devinacker/upd7811-reader/adapter-qfp64/adapter-qfp64.kicad_pcb

## KiCad design adapter-qfp64/adapter-qfp64.kicad_pcb (2026-11-07)

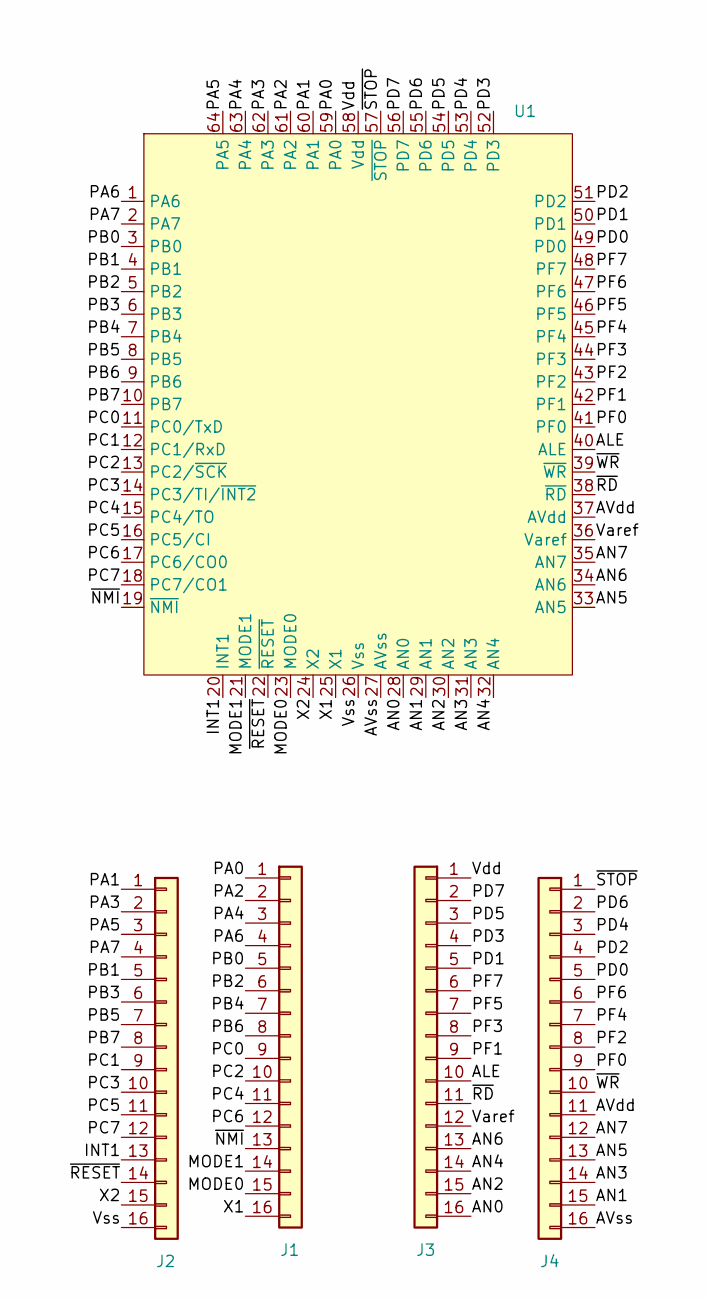
[picture p2: schematic adapter-qfp64.kicad_sch]

Parts:
J1, J2, J3, J4: Conn_01x16; PinHeader_1x16_P2.54mm_Vertical
U1: Package_QFP64

Connections:
/ALE: J3.10, U1.40 (ALE)
/AN0: J3.16, U1.28 (AN0)
/AN1: J4.15, U1.29 (AN1)
/AN2: J3.15, U1.30 (AN2)
/AN3: J4.14, U1.31 (AN3)
/AN4: J3.14, U1.32 (AN4)
/AN5: J4.13, U1.33 (AN5)
/AN6: J3.13, U1.34 (AN6)
/AN7: J4.12, U1.35 (AN7)
/AVdd: J4.11, U1.37 (AVdd)
/AVss: J4.16, U1.27 (AVss)
/INT1: J2.13, U1.20 (INT1)
/MODE0: J1.15, U1.23 (MODE0)
/MODE1: J1.14, U1.21 (MODE1)
/PA0: J1.1, U1.59 (PA0)
/PA1: J2.1, U1.60 (PA1)
/PA2: J1.2, U1.61 (PA2)
/PA3: J2.2, U1.62 (PA3)
/PA4: J1.3, U1.63 (PA4)
/PA5: J2.3, U1.64 (PA5)
/PA6: J1.4, U1.1 (PA6)
/PA7: J2.4, U1.2 (PA7)
/PB0: J1.5, U1.3 (PB0)
/PB1: J2.5, U1.4 (PB1)
/PB2: J1.6, U1.5 (PB2)
/PB3: J2.6, U1.6 (PB3)
/PB4: J1.7, U1.7 (PB4)
/PB5: J2.7, U1.8 (PB5)
/PB6: J1.8, U1.9 (PB6)
/PB7: J2.8, U1.10 (PB7)
/PC0: J1.9, U1.11 (PC0/TxD)
/PC1: J2.9, U1.12 (PC1/RxD)
/PC2: J1.10, U1.13 (PC2/~SCK)
/PC3: J2.10, U1.14 (PC3/TI/~INT2)
/PC4: J1.11, U1.15 (PC4/TO)
/PC5: J2.11, U1.16 (PC5/CI)
/PC6: J1.12, U1.17 (PC6/CO0)
/PC7: J2.12, U1.18 (PC7/CO1)
/PD0: J4.5, U1.49 (PD0)
/PD1: J3.5, U1.50 (PD1)
/PD2: J4.4, U1.51 (PD2)
/PD3: J3.4, U1.52 (PD3)
/PD4: J4.3, U1.53 (PD4)
/PD5: J3.3, U1.54 (PD5)
/PD6: J4.2, U1.55 (PD6)
/PD7: J3.2, U1.56 (PD7)
/PF0: J4.9, U1.41 (PF0)
/PF1: J3.9, U1.42 (PF1)
/PF2: J4.8, U1.43 (PF2)
/PF3: J3.8, U1.44 (PF3)
/PF4: J4.7, U1.45 (PF4)
/PF5: J3.7, U1.46 (PF5)
/PF6: J4.6, U1.47 (PF6)
/PF7: J3.6, U1.48 (PF7)
/Varef: J3.12, U1.36 (Varef)
/Vdd: J3.1, U1.58 (Vdd)
/Vss: J2.16, U1.26 (Vss)
/X1: J1.16, U1.25 (X1)
/X2: J2.15, U1.24 (X2)
/~NMI: J1.13, U1.19 (~NMI)
/~RD: J3.11, U1.38 (~RD)
/~RESET: J2.14, U1.22 (~RESET)
/~STOP: J4.1, U1.57 (~STOP)
/~WR: J4.10, U1.39 (~WR)

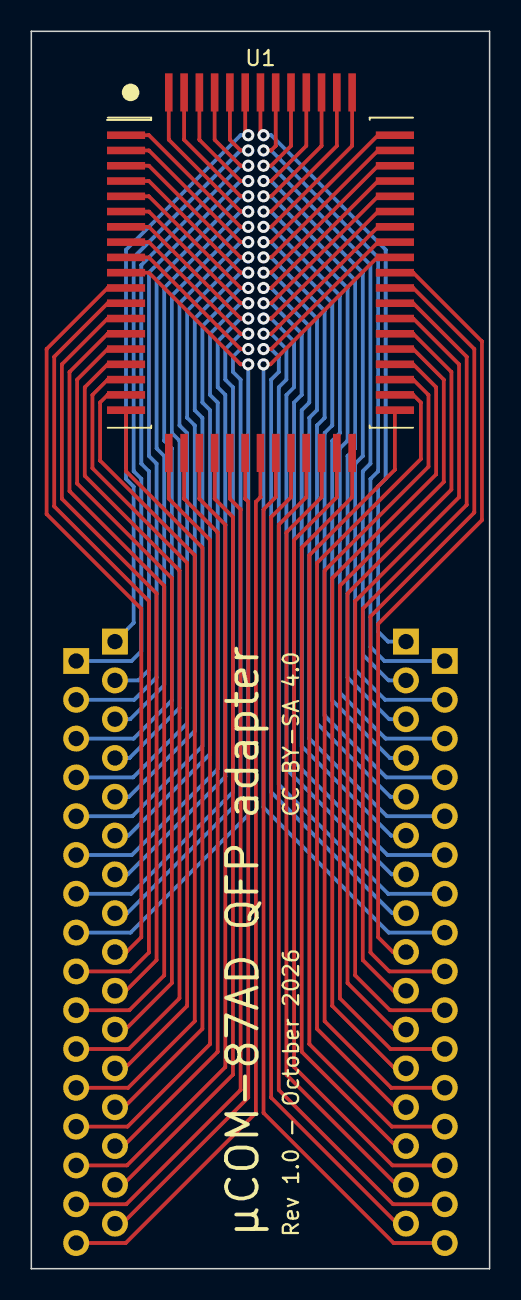
[picture p3: board adapter-qfp64.kicad_pcb from above]

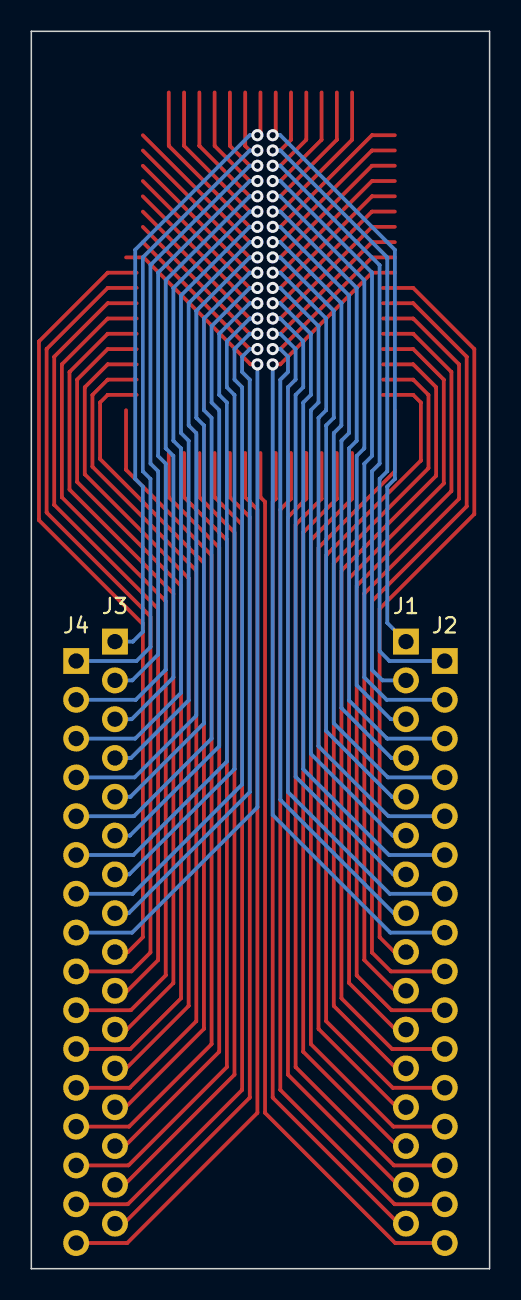
[picture p4: board adapter-qfp64.kicad_pcb from below]

Board: 2 copper layers, 30.0 x 81.0 mm, 5 parts (4 on the bottom side), 64 nets.
