devinacker/upd7811-reader/upd7811-reader.kicad_pcb

## KiCad design upd7811-reader.kicad_pcb (2026-11-07)

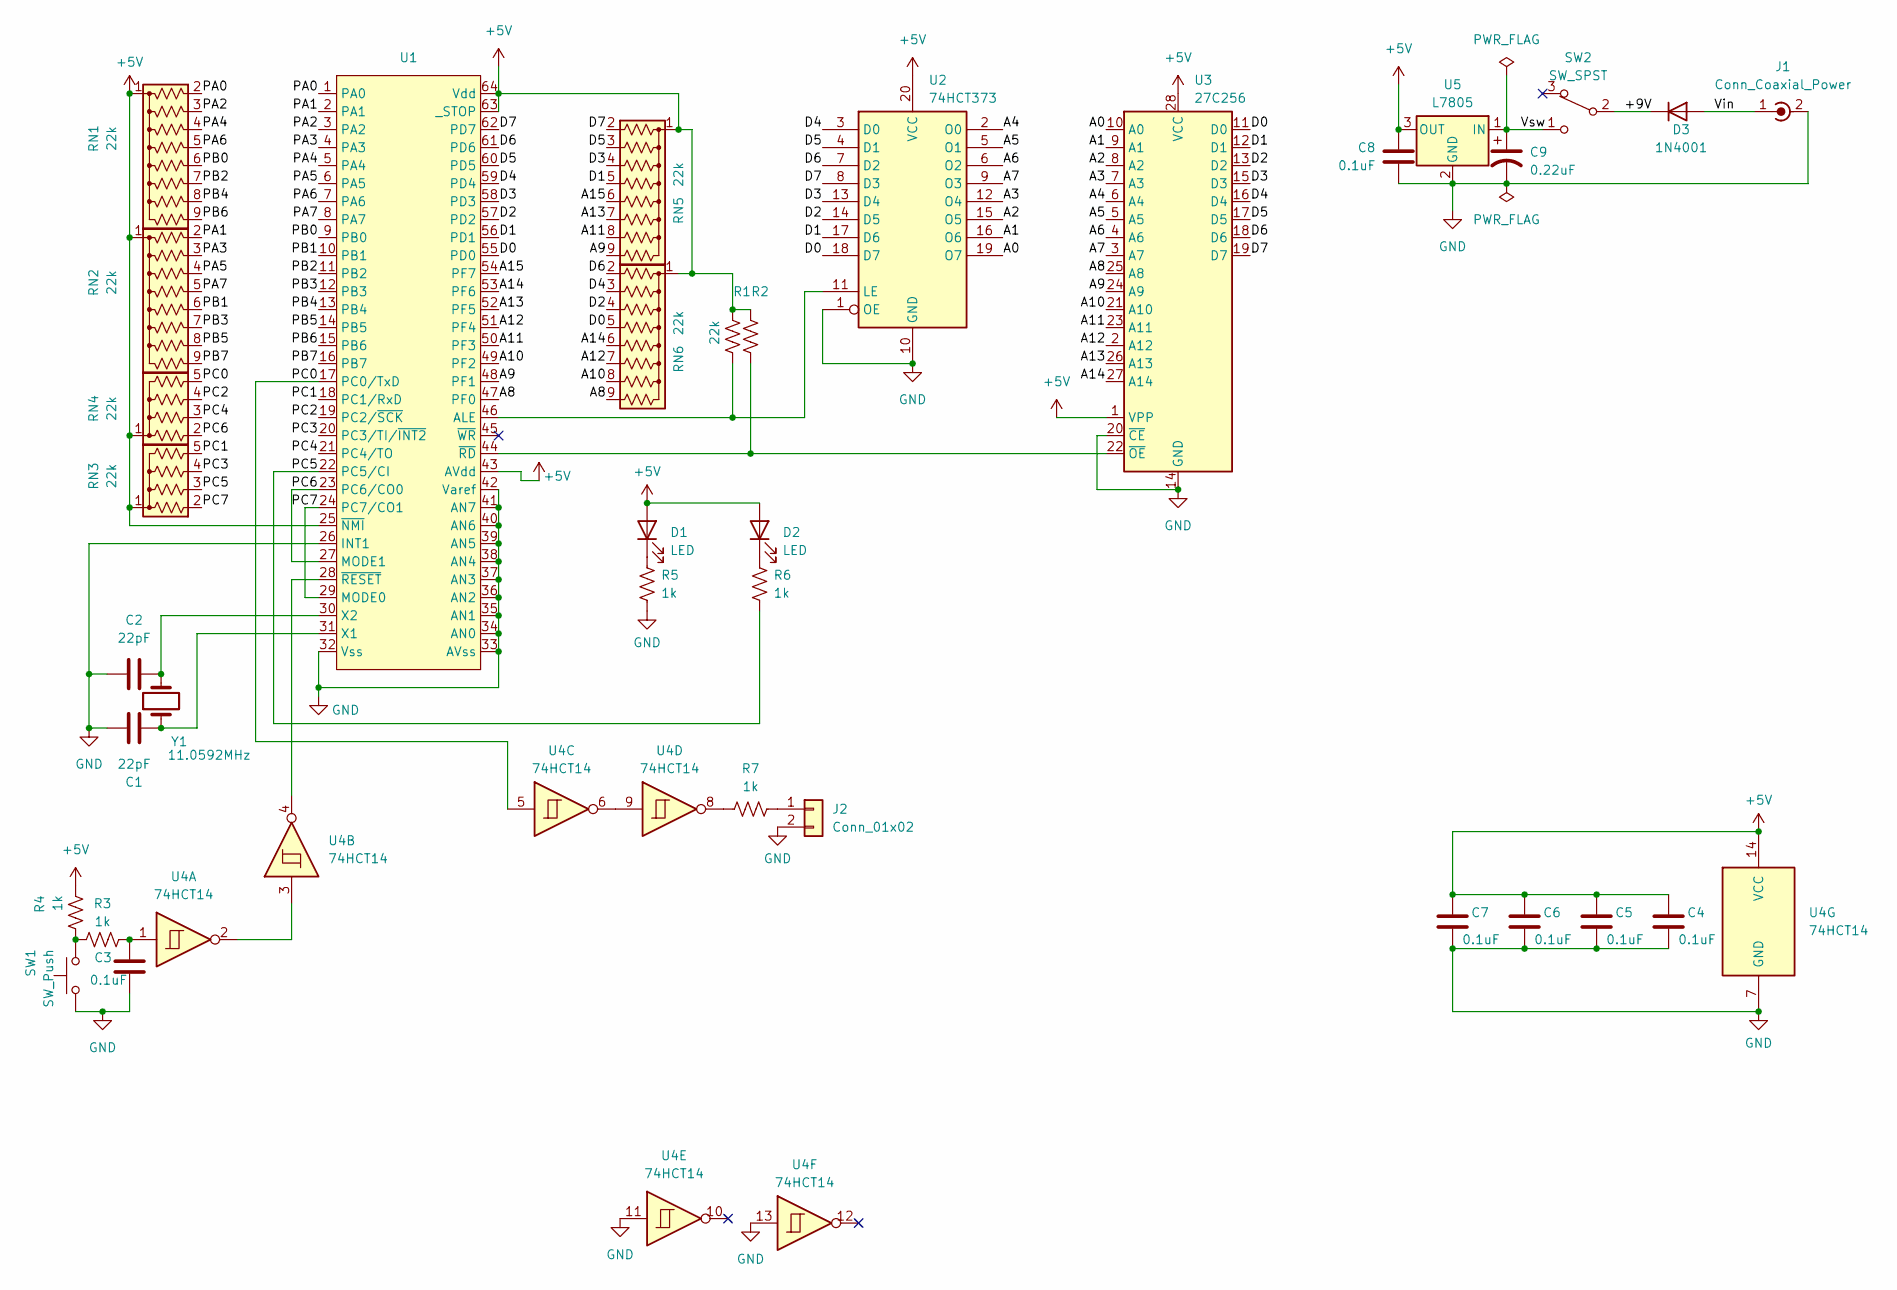
[picture p5: schematic upd7811-reader.kicad_sch, NEC 87AD ROM reader]

Parts:
C1, C2: 22pF; C_Disc_D3.8mm_W2.6mm_P2.50mm
C3, C4, C5, C6, C7, C8: 0.1uF; C_Disc_D3.8mm_W2.6mm_P2.50mm
C9: 0.22uF; CP_Radial_D5.0mm_P2.50mm
D1, D2: LED; LED_D5.0mm
D3: 1N4001; D_DO-41_SOD81_P10.16mm_Horizontal
J1: Conn_Coaxial_Power; BarrelJack_Wuerth_6941xx301002
J2: Conn_01x02; PinHeader_1x02_P2.54mm_Vertical
R1, R2: 22k; R_Axial_DIN0204_L3.6mm_D1.6mm_P5.08mm_Horizontal
R3, R4, R5, R6, R7: 1k; R_Axial_DIN0204_L3.6mm_D1.6mm_P5.08mm_Horizontal
RN1, RN2, RN5, RN6: 22k; R_Array_SIP9
RN3, RN4: 22k; R_Array_SIP5
SW1: SW_Push; SW_PUSH_6mm
SW2: SW_SPST; SW_Slide_1P2T_CK_OS102011MS2Q
U1: Package_QUIP64
U2: 74HCT373; DIP-20_W7.62mm
U3: 27C256; DIP-28_W15.24mm
U4: 74HCT14; DIP-14_W7.62mm
U5: L7805; TO-220-3_Horizontal_TabDown
Y1: 11.0592MHz; Crystal_HC49-4H_Vertical

Connections:
+5V: C4.1, C5.1, C6.1, C7.1, C8.1, D1.2 (A), D2.2 (A), R1.1, R2.1, R4.1, RN1.1 (common), RN2.1 (common), RN3.1 (common), RN4.1 (common), RN5.1 (common), RN6.1 (common), U1.25 (~NMI), U1.43 (AVdd), U1.63 (_STOP), U1.64 (Vdd), U2.20 (VCC), U3.1 (VPP), U3.28 (VCC), U4.14 (VCC), U5.3 (OUT)
/+9V: D3.1 (K), SW2.2 (B)
/A0: U2.19 (O7), U3.10 (A0)
/A1: U2.16 (O6), U3.9 (A1)
/A2: U2.15 (O5), U3.8 (A2)
/A3: U2.12 (O4), U3.7 (A3)
/A4: U2.2 (O0), U3.6 (A4)
/A5: U2.5 (O1), U3.5 (A5)
/A6: U2.6 (O2), U3.4 (A6)
/A7: U2.9 (O3), U3.3 (A7)
/A8: RN6.9 (R8), U1.47 (PF0), U3.25 (A8)
/A9: RN5.9 (R8), U1.48 (PF1), U3.24 (A9)
/A10: RN6.8 (R7), U1.49 (PF2), U3.21 (A10)
/A11: RN5.8 (R7), U1.50 (PF3), U3.23 (A11)
/A12: RN6.7 (R6), U1.51 (PF4), U3.2 (A12)
/A13: RN5.7 (R6), U1.52 (PF5), U3.26 (A13)
/A14: RN6.6 (R5), U1.53 (PF6), U3.27 (A14)
/A15: RN5.6 (R5), U1.54 (PF7)
/D0: RN6.5 (R4), U1.55 (PD0), U2.18 (D7), U3.11 (D0)
/D1: RN5.5 (R4), U1.56 (PD1), U2.17 (D6), U3.12 (D1)
/D2: RN6.4 (R3), U1.57 (PD2), U2.14 (D5), U3.13 (D2)
/D3: RN5.4 (R3), U1.58 (PD3), U2.13 (D4), U3.15 (D3)
/D4: RN6.3 (R2), U1.59 (PD4), U2.3 (D0), U3.16 (D4)
/D5: RN5.3 (R2), U1.60 (PD5), U2.4 (D1), U3.17 (D5)
/D6: RN6.2 (R1), U1.61 (PD6), U2.7 (D2), U3.18 (D6)
/D7: RN5.2 (R1), U1.62 (PD7), U2.8 (D3), U3.19 (D7)
/PA0: RN1.2 (R1), U1.1 (PA0)
/PA1: RN2.2 (R1), U1.2 (PA1)
/PA2: RN1.3 (R2), U1.3 (PA2)
/PA3: RN2.3 (R2), U1.4 (PA3)
/PA4: RN1.4 (R3), U1.5 (PA4)
/PA5: RN2.4 (R3), U1.6 (PA5)
/PA6: RN1.5 (R4), U1.7 (PA6)
/PA7: RN2.5 (R4), U1.8 (PA7)
/PB0: RN1.6 (R5), U1.9 (PB0)
/PB1: RN2.6 (R5), U1.10 (PB1)
/PB2: RN1.7 (R6), U1.11 (PB2)
/PB3: RN2.7 (R6), U1.12 (PB3)
/PB4: RN1.8 (R7), U1.13 (PB4)
/PB5: RN2.8 (R7), U1.14 (PB5)
/PB6: RN1.9 (R8), U1.15 (PB6)
/PB7: RN2.9 (R8), U1.16 (PB7)
/PC0: RN4.5 (R4), U1.17 (PC0/TxD), U4.5
/PC1: RN3.5 (R4), U1.18 (PC1/RxD)
/PC2: RN4.4 (R3), U1.19 (PC2/~SCK)
/PC3: RN3.4 (R3), U1.20 (PC3/TI/~INT2)
/PC4: RN4.3 (R2), U1.21 (PC4/TO)
/PC5: R6.2, RN3.3 (R2), U1.22 (PC5/CI)
/PC6: RN4.2 (R1), U1.23 (PC6/CO0), U1.27 (MODE1)
/PC7: RN3.2 (R1), U1.24 (PC7/CO1), U1.29 (MODE0)
/Vin: D3.2 (A), J1.1 (In)
/Vsw: C9.1, SW2.1 (C), U5.1 (IN)
GND: C1.1, C2.1, C3.2, C4.2, C5.2, C6.2, C7.2, C8.2, C9.2, J1.2 (Ext), J2.2, R5.2, SW1.1, U1.26 (INT1), U1.32 (Vss), U1.33 (AVss), U1.34 (AN0), U1.35 (AN1), U1.36 (AN2), U1.37 (AN3), U1.38 (AN4), U1.39 (AN5), U1.40 (AN6), U1.41 (AN7), U1.42 (Varef), U2.1 (OE), U2.10 (GND), U3.14 (GND), U3.20 (~CE), U4.7 (GND), U4.11, U4.13, U5.2 (GND)
unnamed: C3.1, R3.2, U4.1
unnamed: D1.1 (K), R5.1
unnamed: D2.1 (K), R6.1
unnamed: J2.1, R7.2
unnamed: R3.1, R4.2, SW1.2
unnamed: R7.1, U4.8
unnamed: R1.2, U1.46 (ALE), U2.11 (LE)
unnamed: C1.2, U1.31 (X1), Y1.1
unnamed: C2.2, U1.30 (X2), Y1.2
unnamed: R2.2, U1.44 (~RD), U3.22 (~OE)
unnamed: U1.28 (~RESET), U4.4
unnamed: U4.2, U4.3
unnamed: U4.6, U4.9

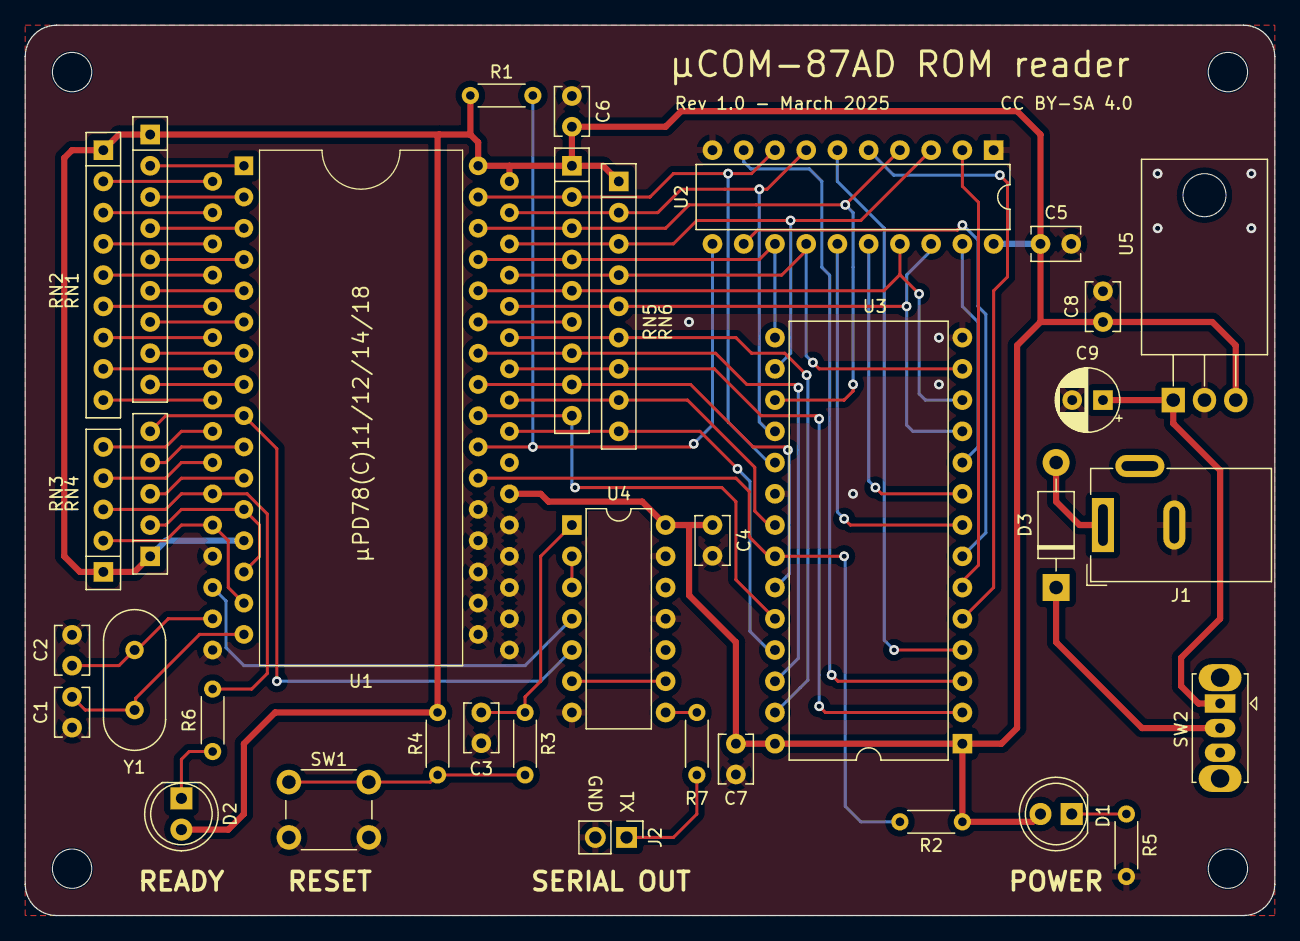
[picture p6: board upd7811-reader.kicad_pcb from above]

Board: 2 copper layers, 101.6 x 72.4 mm, 35 parts (0 on the bottom side), 66 nets.
