devinacker/upd7811-reader/(commit log)

2025-03-08 the rest of everything
    [upd7811-reader.kicad_pcb, upd7811-reader.kicad_sch]
2026-11-07 add QFP adapter
    [adapter-qfp64.kicad_pcb, adapter-qfp64.kicad_sch, upd7811-reader.kicad_pcb, upd7811-reader.kicad_sch]
