devinacker/upd7811-reader/(notices)

Notices in the files:
upd7811-reader.kicad_pcb:
CC BY-SA 4.0
